Balaji-008/battery-management-system/bms_schematic.pdf

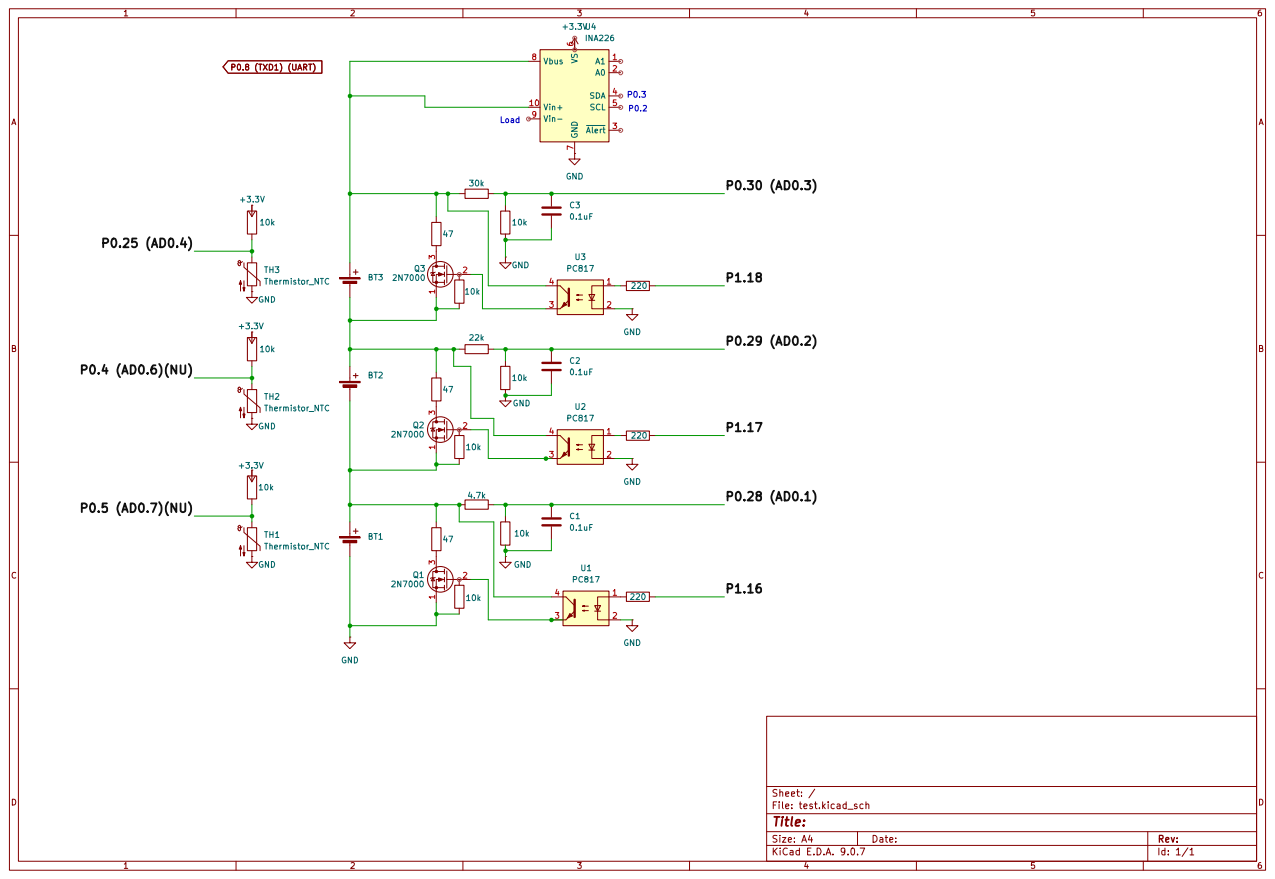
[picture p7: page 1]
