Balaji-008/battery-management-system/(commit log)

2026-05-26 initial commit: add battery management system firmware, physical build gallery, video demo, main schematic, and documentation
2026-05-26 update: rename main circuit diagram to bms_schematic.pdf, convert and embed high-res bms_schematic.png directly in README, and polish author bio
